sparkybg/UniSolder-5.2/BOM/UniSolder52C_front_BOM.xlsx

Designator | Quantity | Comment | Value | Description | Footprint | Package
C23, C47 | 2 | 220uf 10V | 220uf 10V | Tantalum SMD Capacitor | TANT D | D
C24, C25, C26, C27, C28, C29, C30, C31, C32, C33, C34, C35, C38, C39, C41, C42, C43, C44, C45, C46, C48, C49, C50, C51, C52, C53, C54, C58, C78 | 29 | 100n | 100n | Capacitor | 0603 capacitor | 0603
C36, C37, C40, C57, C79, C80, C81, C88 | 8 | 10u 16V | 10u 16V | Capacitor | 0805H Capacitor | 0805
C55, C56 | 2 | 15p | 15p | Capacitor | 0603 capacitor | 0603
C59, C60, C62, C65 | 4 | 10n 100V | 10n 100V | Capacitor | 0805H Capacitor | 0805
C61, C63, C64 | 3 | 1n | 1n | Capacitor | 0805 capacitor | 0805
C66 | 1 | 1n | 1n | Capacitor | 0805H Capacitor | 0805
D16, D20, D21, D23 | 4 | BAV199 |  | Low leakage double diode | SOT23 No Dot | SOT23
D18, D19 | 2 | MMBD1505A |  | Low leakage double diode | SOT23 No Dot | SOT23
ENCODER, OLED1, OLED2 | 3 | Header 5 |  | Header, 5-Pin | HDR1X5
J8 | 1 | CNTR |  | Header, 10-Pin | CABLE HEADER 2x5 2.54mm | 2x5x2.54
J9 | 1 | PWR |  | Header, 6-Pin | MOLEX 39-28-1063 6P
PD1 | 1 | Header 5 |  | Header, 5-Pin | HDR1X5 | 1x5x2.54
Q14, Q16, Q18, Q19, Q21, Q22 | 6 | IRLML6401 |  | HEXFET Power MOSFET | SOT23 No Dot | SOT23
R11, R12, R36, R40, R41, R45, R46, R58 | 8 | 3k | 3k | Resistor | 0805 Resistor | 0805
R23, R27, R28, R33, R44, R57 | 6 | 1.8k | 1.8k | Resistor | 0805 Resistor | 0805
R24, R34, R51, R60 | 4 | 1k 0.1% | 1k 0.1% | Resistor | 0805 Resistor | 0805
R25, R26 | 2 | 27 | 27 | Resistor | 0805 Resistor | 0805
R30, R35, R37, R42, R52, R54, R62, R65 | 8 | 1.5k 0.1% | 1.5k 0.1% | Resistor | 0805 Resistor | 0805
R31, R39 | 2 | 100 0.1% | 100 0.1% | Resistor | 0805 Resistor | 0805
R32 | 1 | 330 | 330 | Resistor | 0805 Resistor | 0805
R38, R48 | 2 | 47k 0.1% | 47k 0.1% | Resistor | 0805 Resistor | 0805
R43, R61, R64 | 3 | 15k | 15k | Resistor | 0805 Resistor | 0805
R47, R49, R50 | 3 | 27k 0.1% | 27k 0.1% | Resistor | 0805 Resistor | 0805
R53, R63 | 2 | 10k 0.1% | 10k 0.1% | Resistor | 0805 Resistor | 0805
R55, R56, R59 | 3 | 1.5k | 1.5k | Resistor | 0805 Resistor | 0805
R70 | 1 | 0 | 0 | Resistor | 0805 Resistor | 0805
Rc2 | 1 | 2k | 2k | Potentiometer | TRIMMER BOURNS 3314J | Bourns 3362
Rgnd1 | 1 | 10000k | 10000k | Resistor | 2512 RES-WIDE | 2512
S1, S2, S3 | 3 | SWITCH-TACTILE |  |  | SWITCH-TACTILE
SPK1 | 1 | PB1221P |  | Speaker 12mm | BUZZER 6.5R12 NO OVERLAY | SPK12x9x6.5
U4 | 1 | TC1047AVNBTR |  | Precision Temperature-to-Voltage Converter, 3-Pin SOT-23, Extended Temperature, Tape and Reel | SOT23 No Dot | SOT23
U5 | 1 | PIC32MX564F128H-I/PT |  | High Performance 80 MHz MIPS-Based 32-Bit Flash Microcontroller with USB and CAN, 128KB Program Memory, 64-pin TQFP, Industrial Temperature | TQFP64-50x1200x1200x120_N | TQFP64
U6 | 1 | REF3030 |  | 3.0V 0.2% 50ppm/C voltage reference | SOT23 No Dot | SOT23
U7 | 1 | ADuM3160 |  | USB Isolator | SOIC16W | SOIC16W
U8 | 1 | 24LC64-I/SN |  | 64Kbit, 400kHz, 2.5V, I2C Serial EEPROM, 8-Pin SOIC 150mil, Industrial Temperature | SOIC 8 | SOIC8
U10 | 1 | MCP4651-503E/ST |  | 8-Bit Dual I2C Digital POT with Volatile Memory, 14-pin TSSOP, Extended Temperature | TSSOP 14 | TSSOP14
U11 | 1 | MCP4716A0T-E/CH |  | 10-Bit Voltage Output Digital-to-Analog Converter with EEPROM and I2C Interface, 6-Pin SOT-23, Extended Temperature, Tape and Reel | SOT23-6 | SOT23-6
U12, U13 | 2 | MCP6V27-E/SN |  | 110 µA, High Precision Dual Op Amp, 8-Pin SOIC, Extended Temperature, 620 µA, 2 MHz Auto-Zeroed Dual Op Amp, 8-Pin SOIC, Extended Temperature | SOIC 8 NO DOT | SOIC8
U14 | 1 | LM4041CIM3-1.2 |  | Precision Micropower Shunt Voltage Reference, 3-pin SOT-23 | SOT23 No Dot | SOT23
U15 | 1 | MCP4561T-503E/MS |  | 8-Bit Single I2C Digital POT with Non-Volatile Memory, 8-pin MSOP, Extended Temperature, Tape and Reel | MSOP 8 DGK | MSOP8
U16 | 1 | ADG734 |  | AD 4 SPDT | TSSOP 20 | TSSOP20
U17 | 1 | MCP6V28-E/SN |  | 620 µA, 2 MHz Auto-Zeroed Op Amp with CS pin, 8-Pin SOIC, Extended Temperature | SOIC 8 NO DOT | SOIC8
U18 | 1 | MCP6V27-E/SN |  | 620 µA, 2 MHz Auto-Zeroed Dual Op Amp, 8-Pin SOIC, Extended Temperature | SOIC 8 | SOIC8
USB1 | 1 | USB 5 pin |  | Mini USB vertical connector | USB-B VERT MINI WURTH | MINIUSB-V
Y1 | 1 | 8Mhz | 8Mhz | Crystal Oscillator | HC49US | HC49US
ZD4 | 1 | 3V | 3V | Zener Diode | SOD123/miniMELF | SOD123
