sparkybg/UniSolder-5.2/BOM/UniSolder52C_full_BOM.xlsx

Designator | Quantity | Comment | Value | Description | Footprint | Package
C1, C3, C5, C7, C9, C10, C17, C18, C59, C60, C62, C65, C85, C86 | 14 | 10n 100V | 10n 100V | Capacitor | 0805H Capacitor | 0805
C2, C6, C12, C16, C20, C21, C67, C70, C73, C74, C77, C82, C87 | 13 | 100n 100V | 100n 100V | Capacitor, Capacitor (Semiconductor SIM Model) | 0805H Capacitor | 0805
C4 | 1 | 470uF 16V | 470uF 16V | Polarized Capacitor (Radial) | ELCAP 10x12.5 | TH10x12.5
C8, C11 | 2 | 220uF 50V | 220uF 50V | Polarized Capacitor (Radial) | ELCAP 10x12.5 | TH10x12.5
C13 | 1 | 22uF 50V | 22uF 50V | Polarized Capacitor (Radial) | ELCAP 5x11 RM2.0 | TH5x11
C14, C15, C19, C83 | 4 | 10u 25V | 10u 25V | Capacitor | 1206 Capacitor | 1206
C22 | 1 | 47uF 100V | 47uF 100V | Polarized Capacitor (Radial) | ELCAP 10x12.5 | TH10x12.5
C23, C47, C84 | 3 | 220uf 10V | 220uf 10V | Tantalum SMD Capacitor | TANT D | D
C24, C25, C26, C27, C28, C29, C30, C31, C32, C33, C34, C35, C38, C39, C41, C42, C43, C44, C45, C46, C48, C49, C50, C51, C52, C53, C54, C58, C78 | 29 | 100n | 100n | Capacitor | 0603 capacitor | 0603
C36, C37, C40, C57, C68, C69, C75, C79, C80, C81, C88 | 11 | 10u 16V | 10u 16V | Capacitor | 0805H Capacitor | 0805
C55, C56 | 2 | 15p | 15p | Capacitor | 0603 capacitor | 0603
C61, C63, C64 | 3 | 1n | 1n | Capacitor | 0805 capacitor | 0805
C66 | 1 | 1n | 1n | Capacitor | 0805H Capacitor | 0805
C71 | 1 | 10u 25V | 10u 25V | Capacitor | 1206H Capacitor | 0805
C76 | 1 | 100p | 100p | Capacitor | 0805 Capacitor | 0805
D1, D2, D3, D4 | 4 | FERD30H100SB-TR |  | FERD/Schottky Diode, FRTD/Schottky Diode | TO-252/D-PAK - diode | DO-201AD
D5, D8, D10, D14, D15 | 5 | BAT46WH |  | Schottky Rectifier | SOD123/miniMELF | SOD123
D6, D7, D12 | 3 | SS310A |  | Schottky Rectifier | DIODE SMA | SMA
D9, D11, D13 | 3 | 1N4007 |  | 1 Amp General Purpose Rectifier | DIODE SMA | SMA
D16, D20, D21, D23 | 4 | BAV199 |  | Low leakage double diode | SOT23 No Dot | SOT23
D18, D19 | 2 | MMBD1505A |  | Low leakage double diode | SOT23 No Dot | SOT23
D22 | 1 | SS34A |  | Schottky Rectifier | DIODE SMA | SMA
DISPLAY | 1 | UG-2864HSWEG01 |  | 0.96' 128x64 OLED Display | OLED 30X0.7
ENCODER, OLED1, OLED2 | 3 | Header 5 |  | Header, 5-Pin | HDR1X5
FUSE1 | 1 | F6.3A |  | LITTLEFUSE 0154 + HOLDER | 0154 Fuse+holder
J1 | 1 | 24VAC |  | Header, 2-Pin | MOLEX 39-28-1023 2P | 1x2x4.2
J2 | 1 | IRON |  | Header, 4-Pin | MOLEX 39-28-8040 4P | 2x2x4.2
J3, J9 | 2 | PWR |  | Header, 6-Pin | MOLEX 39-28-1063 6P
J4, J8 | 2 | CNTR |  | Header, 10-Pin | CABLE HEADER 2x5 2.54mm | 2x5x2.54
J5 | 1 | HOLDER |  | Header, 8-Pin | RJ11 VERT | RJ11V
J6 | 1 | SENSOR |  | Header, 3-Pin | CI31-3 | CI31-3
J7 | 1 | 24VDC |  | Header, 2-Pin | MOLEX 39-28-1023 2P | 1x2x4.2
L1 | 1 | 330uH | 330uH | Inductor | DRH125 Inductor | DRH125
L2, L4 | 2 | 330uH | 330uH | Inductor | DRH74 INDUCTOR | DRH74
L3 | 1 | 10uH | 10uH | Inductor | LPS4018 INDUCTOR | LPS4018
P1, P2 | 2 | Header 5 |  | Header, 5-Pin | Pin Header 2.54mm 1x5 | 1x5x2.54
PD1 | 1 | Header 5 |  | Header, 5-Pin | HDR1X5 | 1x5x2.54
Q1 | 1 | MJD122 |  | SOT223 NPN Silicon Planar Medium Power Darlington Transistor | SOT223+DPAK/TO252 | SOT89
Q2, Q8 | 2 | SUD50P08 |  | HEXFET Power MOSFET | TO-252/D-PAK | TO252
Q3, Q9 | 2 | MMBT5401 |  | PNP General-purpose Transistor | SOT23 No Dot | SOT23
Q4, Q5, Q12 | 3 | MMBT5551 |  | NPN General-purpose Transistor | SOT23 No Dot | SOT23
Q6, Q13 | 2 | BC847C |  | NPN General-purpose Transistor | SOT23 No Dot | SOT23
Q7 | 1 | BCX56-16 |  | NPN High-voltage Transistor | SOT89 | SOT89
Q10, Q11 | 2 | IPD053N08 |  | HEXFET N-Channel Power MOSFET | TO-252/D-PAK | TO252
Q14, Q16, Q18, Q19, Q21, Q22 | 6 | IRLML6401 |  | HEXFET Power MOSFET | SOT23 No Dot | SOT23
R1 | 1 | 10k | 10k | Resistor | 1206 Resistor | 1206
R2, R7, R15, R19, R21, R22 | 6 | 4.7k | 4.7k | Resistor | 0805 Resistor | 0805
R3 | 1 | 0 | 0 | Resistor | 0805 Resistor/Jumper | 0805
R4, R30, R35, R37, R42, R52, R54, R62, R65 | 9 | 1.5k 0.1% | 1.5k 0.1% | Resistor | 0805 Resistor | 0805
R5, R11, R12, R13, R16, R17, R36, R40, R41, R45, R46, R58, R68, R69 | 14 | 3k | 3k | Resistor | 0805 Resistor | 0805
R6, R9, R14 | 3 | 150 | 150 | Resistor | 0805 Resistor | 0805
R8, R18 | 2 | 30k | 30k | Resistor | 0805 Resistor | 0805
R10 | 1 | 10k | 10k | Resistor | 1206 Resistor | 0805
R20, R32 | 2 | 330 | 330 | Resistor | 0805 Resistor | 0805
R23, R27, R28, R33, R44, R57 | 6 | 1.8k | 1.8k | Resistor | 0805 Resistor | 0805
R24, R34, R51, R60 | 4 | 1k 0.1% | 1k 0.1% | Resistor | 0805 Resistor | 0805
R25, R26 | 2 | 27 | 27 | Resistor | 0805 Resistor | 0805
R31, R39 | 2 | 100 0.1% | 100 0.1% | Resistor | 0805 Resistor | 0805
R38, R48 | 2 | 47k 0.1% | 47k 0.1% | Resistor | 0805 Resistor | 0805
R43, R61, R64 | 3 | 15k | 15k | Resistor | 0805 Resistor | 0805
R47, R49, R50, R66 | 4 | 27k 0.1% | 27k 0.1% | Resistor | 0805 Resistor | 0805
R53, R63 | 2 | 10k 0.1% | 10k 0.1% | Resistor | 0805 Resistor | 0805
R55, R56, R59 | 3 | 1.5k | 1.5k | Resistor | 0805 Resistor | 0805
R67 | 1 | 820k | 820k | Resistor | 0805 Resistor | 0805
R70 | 1 | 0 | 0 | Resistor | 0805 Resistor | 0805
Rc2 | 1 | 2k | 2k | Potentiometer | TRIMMER BOURNS 3314J | Bourns 3362
Rgnd1 | 1 | 10000k | 10000k | Resistor | 2512 RES-WIDE | 2512
Rs1 | 1 | 0.003 | 0.003 | 4lead shunt resistor | RES VISHAY WSL3637 | WSL3637
S1, S2, S3 | 3 | SWITCH-TACTILE |  |  | SWITCH-TACTILE
SPK1 | 1 | PB1221P |  | Speaker 12mm | BUZZER 6.5R12 NO OVERLAY | SPK12x9x6.5
TVS1 | 1 | 60V |  | Tranzorb | DIODE SMC | DO-201AD
U1 | 1 | LM2675M-3.3 |  | SIMPLE SWITCHER® Power Converter High Efficiency 1A Step-Down Voltage Regulator, 8-pin Narrow SOIC | SOIC 8 | SOIC8
U2 | 1 | TC4428ACOA |  | 1.5A Dual High-Speed Power MOSFET Driver, Complementary, Commercial Temperature | SOIC 8 NO DOT | SOIC8
U3 | 1 | SN74HC02D |  | Quadruple 2-Input Positive-NOR Gate | SOIC 14 | SOIC14
U4 | 1 | TC1047AVNBTR |  | Precision Temperature-to-Voltage Converter, 3-Pin SOT-23, Extended Temperature, Tape and Reel | SOT23 No Dot | SOT23
U5 | 1 | PIC32MX564F128H-I/PT |  | High Performance 80 MHz MIPS-Based 32-Bit Flash Microcontroller with USB and CAN, 128KB Program Memory, 64-pin TQFP, Industrial Temperature | TQFP64-50x1200x1200x120_N | TQFP64
U6 | 1 | REF3030 |  | 3.0V 0.2% 50ppm/C voltage reference | SOT23 No Dot | SOT23
U7 | 1 | ADuM3160 |  | USB Isolator | SOIC16W | SOIC16W
U8 | 1 | 24LC64-I/SN |  | 64Kbit, 400kHz, 2.5V, I2C Serial EEPROM, 8-Pin SOIC 150mil, Industrial Temperature | SOIC 8 | SOIC8
U10 | 1 | MCP4651-503E/ST |  | 8-Bit Dual I2C Digital POT with Volatile Memory, 14-pin TSSOP, Extended Temperature | TSSOP 14 | TSSOP14
U11 | 1 | MCP4716A0T-E/CH |  | 10-Bit Voltage Output Digital-to-Analog Converter with EEPROM and I2C Interface, 6-Pin SOT-23, Extended Temperature, Tape and Reel | SOT23-6 | SOT23-6
U12, U13 | 2 | MCP6V27-E/SN |  | 110 µA, High Precision Dual Op Amp, 8-Pin SOIC, Extended Temperature, 620 µA, 2 MHz Auto-Zeroed Dual Op Amp, 8-Pin SOIC, Extended Temperature | SOIC 8 NO DOT | SOIC8
U14 | 1 | LM4041CIM3-1.2 |  | Precision Micropower Shunt Voltage Reference, 3-pin SOT-23 | SOT23 No Dot | SOT23
U15 | 1 | MCP4561T-503E/MS |  | 8-Bit Single I2C Digital POT with Non-Volatile Memory, 8-pin MSOP, Extended Temperature, Tape and Reel | MSOP 8 DGK | MSOP8
U16 | 1 | ADG734 |  | AD 4 SPDT | TSSOP 20 | TSSOP20
U17 | 1 | MCP6V28-E/SN |  | 620 µA, 2 MHz Auto-Zeroed Op Amp with CS pin, 8-Pin SOIC, Extended Temperature | SOIC 8 NO DOT | SOIC8
U18 | 1 | MCP6V27-E/SN |  | 620 µA, 2 MHz Auto-Zeroed Dual Op Amp, 8-Pin SOIC, Extended Temperature | SOIC 8 | SOIC8
U19 | 1 | FAN5331 |  | LED boost driver | SOT23-6 | SOT23-5
USB1 | 1 | USB 5 pin |  | Mini USB vertical connector | USB-B VERT MINI WURTH | MINIUSB-V
Y1 | 1 | 8Mhz | 8Mhz | Crystal Oscillator | HC49US | HC49US
ZD1, ZD2, ZD4 | 3 | 3V | 3V | Zener Diode | SOD123/miniMELF | SOD123
ZD3 | 1 | 36V | 36V | Zener Diode | DIODE SMB | SOD123
ZD5, ZD6, ZD7 | 3 | 15V | 15V | Zener Diode | SOD123/miniMELF | SOD123
