sparkybg/UniSolder-5.2/BOM/UniSolder52C_back_OLED_BOM.xlsx

Designator | Quantity | Comment | Value | Description | Footprint | Package
C1, C3, C5, C7, C9, C10, C17, C18, C85, C86 | 10 | 10n 100V | 10n 100V | Capacitor | 0805H Capacitor | 0805
C2, C6, C12, C16, C20, C21, C87 | 7 | 100n 100V | 100n 100V | Capacitor | 0805H Capacitor | 0805
C4 | 1 | 470uF 16V | 470uF 16V | Polarized Capacitor (Radial) | ELCAP 10x12.5 | TH10x12.5
C8, C11 | 2 | 220uF 50V | 220uF 50V | Polarized Capacitor (Radial) | ELCAP 10x12.5 | TH10x12.5
C13 | 1 | 22uF 50V | 22uF 50V | Polarized Capacitor (Radial) | ELCAP 5x11 RM2.0 | TH5x11
C14, C15, C19, C83 | 4 | 10u 25V | 10u 25V | Capacitor | 1206 Capacitor | 1206
C22 | 1 | 47uF 100V | 47uF 100V | Polarized Capacitor (Radial) | ELCAP 10x12.5 | TH10x12.5
C67, C70, C73, C74, C77 | 5 | 100n 100V |  | Capacitor (Semiconductor SIM Model), Capacitor | 0805H Capacitor
C68, C69, C75 | 3 | 10u 16V |  | Capacitor | 0805H Capacitor
C71 | 1 | 10u 25V |  | Capacitor | 1206H Capacitor
C76 | 1 | 100p |  | Capacitor | 0805 Capacitor
C82 | 1 | 100n | 100n | Capacitor | 0805H Capacitor | 0805
C84 | 1 | 220uf 10V | 220uf 10V | Tantalum SMD Capacitor | TANT D | D
D1, D2, D3, D4 | 4 | FERD30H100SB-TR |  | FERD/Schottky Diode, FRTD/Schottky Diode | TO-252/D-PAK - diode | DO-201AD
D5, D8, D10, D14, D15 | 5 | BAT46WH |  | Schottky Rectifier | SOD123/miniMELF | SOD123
D6, D7, D12 | 3 | SS310A |  | Schottky Rectifier | DIODE SMA | SMA
D9, D11, D13 | 3 | 1N4007 |  | 1 Amp General Purpose Rectifier | DIODE SMA | SMA
D22 | 1 | SS34A |  | Schottky Rectifier | DIODE SMA
DISPLAY1 | 1 | UG-2864HSWEG01 |  | 0.96' 128x64 OLED Display | OLED 30X0.7
FUSE1 | 1 | F6.3A |  | LITTLEFUSE 0154 + HOLDER | 0154 Fuse+holder
J1 | 1 | 24VAC |  | Header, 2-Pin | MOLEX 39-28-1023 2P | 1x2x4.2
J2 | 1 | IRON |  | Header, 4-Pin | MOLEX 39-28-8040 4P | 2x2x4.2
J3 | 1 | PWR |  | Header, 6-Pin | MOLEX 39-28-1063 6P
J4 | 1 | CNTR |  | Header, 10-Pin | CABLE HEADER 2x5 2.54mm | 2x5x2.54
J5 | 1 | HOLDER |  | Header, 8-Pin | RJ11 VERT | RJ11V
J6 | 1 | SENSOR |  | Header, 3-Pin | CI31-3 | CI31-3
J7 | 1 | 24VDC |  | Header, 2-Pin | MOLEX 39-28-1023 2P | 1x2x4.2
L1 | 1 | 330uH | 330uH | Inductor | DRH125 Inductor | DRH125
L2, L4 | 2 | 330uH | 330uH | Inductor | DRH74 INDUCTOR | DRH74
L3 | 1 | 10uH |  | Inductor | LPS4018 INDUCTOR
P1, P2 | 2 | Header 5 |  | Header, 5-Pin | PIN HEADER 2.54MM 1X5
Q1 | 1 | MJD122 |  | SOT223 NPN Silicon Planar Medium Power Darlington Transistor | SOT223+DPAK/TO252 | SOT89
Q2, Q8 | 2 | SUD50P08 |  | HEXFET Power MOSFET | TO-252/D-PAK | TO252
Q3, Q9 | 2 | MMBT5401 |  | PNP General-purpose Transistor | SOT23 No Dot | SOT23
Q4, Q5, Q12 | 3 | MMBT5551 |  | NPN General-purpose Transistor | SOT23 No Dot | SOT23
Q6, Q13 | 2 | BC847C |  | NPN General-purpose Transistor | SOT23 No Dot | SOT23
Q7 | 1 | BCX56-16 |  | NPN High-voltage Transistor | SOT89 | SOT89
Q10, Q11 | 2 | IPD053N08 |  | HEXFET N-Channel Power MOSFET | TO-252/D-PAK | TO252
R1 | 1 | 10K | 10k | Resistor | 1206 Resistor | 1206
R2, R7, R15, R19, R21, R22 | 6 | 4.7K | 4.7k | Resistor | 0805 Resistor | 0805
R3 | 1 | 0 | 0 | Resistor | 0805 Resistor/Jumper | 0805
R4 | 1 | 1.5k 0.1% | 1.5k 0.1% | Resistor | 0805 Resistor | 0805
R5, R13, R16, R17 | 4 | 3k | 3k | Resistor | 0805 Resistor | 0805
R6, R9, R14 | 3 | 150 | 150 | Resistor | 0805 Resistor | 0805
R8, R18 | 2 | 30k | 30k | Resistor | 0805 Resistor | 0805
R10 | 1 | 10k | 10k | Resistor | 1206 Resistor | 0805
R20 | 1 | 330 | 330 | Resistor | 0805 Resistor | 0805
R66 | 1 | 27k 0.1% |  | Resistor | 0805 Resistor
R67 | 1 | 820k |  | Resistor | 0805 Resistor
R68, R69 | 2 | 3k |  | Resistor | 0805 Resistor
Rs1 | 1 | 0.003 | 0.003 | 4lead shunt resistor | RES VISHAY WSL3637 | WSL3637
TVS1 | 1 | 60V |  | Tranzorb | DIODE SMC | DO-201AD
U1 | 1 | LM2675M-3.3 |  | SIMPLE SWITCHER® Power Converter High Efficiency 1A Step-Down Voltage Regulator, 8-pin Narrow SOIC | SOIC 8 | SOIC8
U2 | 1 | TC4428ACOA |  | 1.5A Dual High-Speed Power MOSFET Driver, Complementary, Commercial Temperature | SOIC 8 NO DOT | SOIC8
U3 | 1 | SN74HC02D |  | Quadruple 2-Input Positive-NOR Gate | SOIC 14 | SOIC14
U19 | 1 | FAN5331 |  | LED boost driver | SOT23-6
ZD1, ZD2 | 2 | 3V | 3V | Zener Diode | SOD123/miniMELF | SOD123
ZD3 | 1 | 36V | 36V | Zener Diode | DIODE SMB | SOD123
ZD5, ZD6, ZD7 | 3 | 15V | 15V | Zener Diode | SOD123/miniMELF | SOD123
