sparkybg/UniSolder-5.2/BOM/UniSolder52C_back_BOM.xlsx

Designator | Quantity | Comment | Package | Description | Footprint
C1, C3, C5, C7, C9, C10, C17, C18, C85, C86 | 10 | 10n 100V | 0805 | Capacitor | 0805H Capacitor
C2, C6, C12, C16, C20, C21, C82, C87 | 8 | 100n 100V | 0805 | Capacitor | 0805H Capacitor
R2, R7, R15, R19, R21, R22 | 6 | 4.7k | 0805 | Resistor | 0805 Resistor
D5, D8, D10, D14, D15 | 5 | BAT46WH | SOD123 | Schottky Rectifier | SOD123/miniMELF
C14, C15, C19, C83 | 4 | 10u 25V | 1206 | Capacitor | 1206 Capacitor
D1, D2, D3, D4 | 4 | FERD30H100SB-TR | DO-201AD | FERD/Schottky Diode, FRTD/Schottky Diode | TO-252/D-PAK - diode
R5, R13, R16, R17 | 4 | 3k | 0805 | Resistor | 0805 Resistor
D6, D7, D12 | 3 | SS310A | SMA | Schottky Rectifier | DIODE SMA
D9, D11, D13 | 3 | 1N4007 | SMA | 1 Amp General Purpose Rectifier | DIODE SMA
Q4, Q5, Q12 | 3 | MMBT5551 | SOT23 | NPN General-purpose Transistor | SOT23 No Dot
R6, R9, R14 | 3 | 150 | 0805 | Resistor | 0805 Resistor
ZD5, ZD6, ZD7 | 3 | 15V | SOD123 | Zener Diode | SOD123/miniMELF
C8, C11 | 2 | 220uF 50V | TH10x12.5 | Polarized Capacitor (Radial) | ELCAP 10x12.5
L2, L4 | 2 | 330uH | DRH74 | Inductor | DRH74 INDUCTOR
Q2, Q8 | 2 | SUD50P08 | TO252 | HEXFET Power MOSFET | TO-252/D-PAK
Q3, Q9 | 2 | MMBT5401 | SOT23 | PNP General-purpose Transistor | SOT23 No Dot
Q6, Q13 | 2 | BC847C | SOT23 | NPN General-purpose Transistor | SOT23 No Dot
Q10, Q11 | 2 | IPD053N08 | TO252 | HEXFET N-Channel Power MOSFET | TO-252/D-PAK
R1, R10 | 2 | 10k | 1206, 0805 | Resistor | 1206 Resistor
R8, R18 | 2 | 30k | 0805 | Resistor | 0805 Resistor
ZD1, ZD2 | 2 | 3V | SOD123 | Zener Diode | SOD123/miniMELF
C4 | 1 | 470uF 16V | TH10x12.5 | Polarized Capacitor (Radial) | ELCAP 10x12.5
C13 | 1 | 22uF 50V | TH5x11 | Polarized Capacitor (Radial) | ELCAP 5x11 RM2.0
C22 | 1 | 47uF 100V | TH10x12.5 | Polarized Capacitor (Radial) | ELCAP 10x12.5
C84 | 1 | 220uf 10V | D | Tantalum SMD Capacitor | TANT D
FUSE1 | 1 | F6.3A |  | LITTLEFUSE 0154 + HOLDER | 0154 Fuse+holder
J1 | 1 | 24VAC | 1x2x4.2 | Header, 2-Pin | MOLEX 39-28-1023 2P
J2 | 1 | IRON | 2x2x4.2 | Header, 4-Pin | MOLEX 39-28-8040 4P
J3 | 1 | PWR |  | Header, 6-Pin | MOLEX 39-28-1063 6P
J4 | 1 | CNTR | 2x5x2.54 | Header, 10-Pin | CABLE HEADER 2x5 2.54mm
J5 | 1 | HOLDER | RJ11V | Header, 8-Pin | RJ11 VERT
J6 | 1 | SENSOR | CI31-3 | Header, 3-Pin | CI31-3
J7 | 1 | 24VDC | 1x2x4.2 | Header, 2-Pin | MOLEX 39-28-1023 2P
L1 | 1 | 330uH | DRH125 | Inductor | DRH125 Inductor
Q1 | 1 | MJD122 | SOT89 | SOT223 NPN Silicon Planar Medium Power Darlington Transistor | SOT223+DPAK/TO252
Q7 | 1 | BCX56-16 | SOT89 | NPN High-voltage Transistor | SOT89
R3 | 1 | 0 | 0805 | Resistor | 0805 Resistor/Jumper
R4 | 1 | 1.5k 0.1% | 0805 | Resistor | 0805 Resistor
R20 | 1 | 330 | 0805 | Resistor | 0805 Resistor
Rs1 | 1 | 0.003 | WSL3637 | 4lead shunt resistor | RES VISHAY WSL3637
TVS1 | 1 | 60V | DO-201AD | Tranzorb | DIODE SMC
U1 | 1 | LM2675M-3.3 | SOIC8 | SIMPLE SWITCHER® Power Converter High Efficiency 1A Step-Down Voltage Regulator, 8-pin Narrow SOIC | SOIC 8
U2 | 1 | TC4428ACOA | SOIC8 | 1.5A Dual High-Speed Power MOSFET Driver, Complementary, Commercial Temperature | SOIC 8 NO DOT
U3 | 1 | SN74HC02D | SOIC14 | Quadruple 2-Input Positive-NOR Gate | SOIC 14
ZD3 | 1 | 36V | SOD123 | Zener Diode | DIODE SMB
