sparkybg/UniSolder-5.2/BOM/UniSolder52C_OLED_BOM.xlsx

Designator | Quantity | Comment | Description | Package | Value
DISPLAY | 1 | UG-2864HSWEG01 | 0.96' 128x64 OLED Display
C68, C69, C75 | 3 | 10u 16V | Capacitor | 0805 | 10u 16V
C71 | 1 | 10u 25V | Capacitor | 0805 | 10u 25V
C76 | 1 | 100p | Capacitor | 0805 | 100p
C67, C70, C73, C74, C77 | 5 | 100n 100V | Capacitor (Semiconductor SIM Model), Capacitor | 0805 | 100n 100V
P1, P2 | 2 | Header 5 | Header, 5-Pin | 1x5x2.54
L3 | 1 | 10uH | Inductor | LPS4018 | 10uH
U19 | 1 | FAN5331 | LED boost driver | SOT23-5
R66 | 1 | 27k 0.1% | Resistor | 0805 | 27k 0.1%
R67 | 1 | 820k | Resistor | 0805 | 820k
R68, R69 | 2 | 3k | Resistor | 0805 | 3k
D22 | 1 | SS34A | Schottky Rectifier | SMA
