sparkybg/UniSolder-5.2/(list of files, cad)

Other CAD files:
software/sensor/US_sensor.X/dist/default/production/US_sensor.X.production.obj
software/sensor/US_sensor.X/l.obj
