sparkybg/UniSolder-5.2/img/UniSolder52_back.jpg

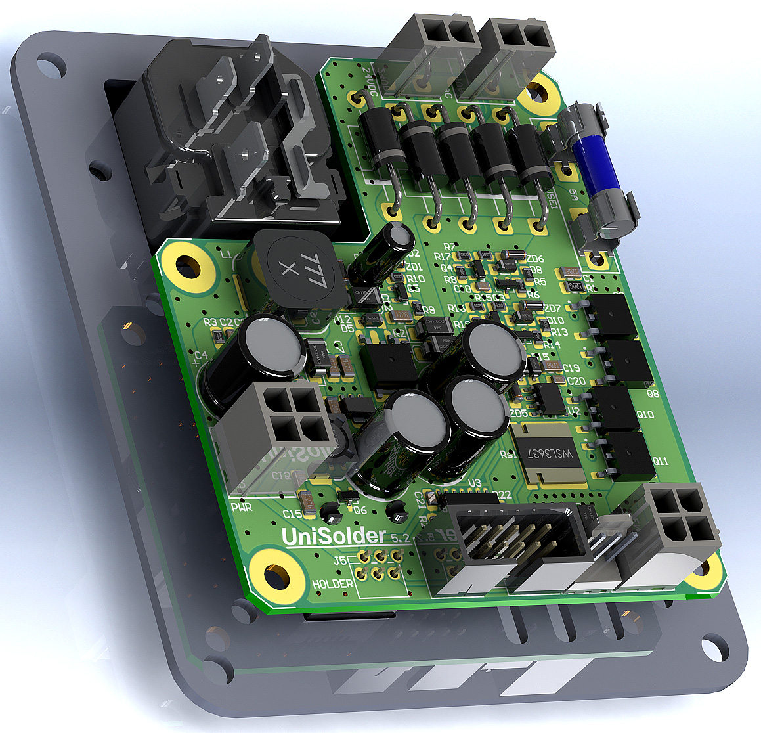
img/UniSolder52_back.jpg
