sparkybg/UniSolder-5.2/img/UniSolder52_front_OLED.jpg

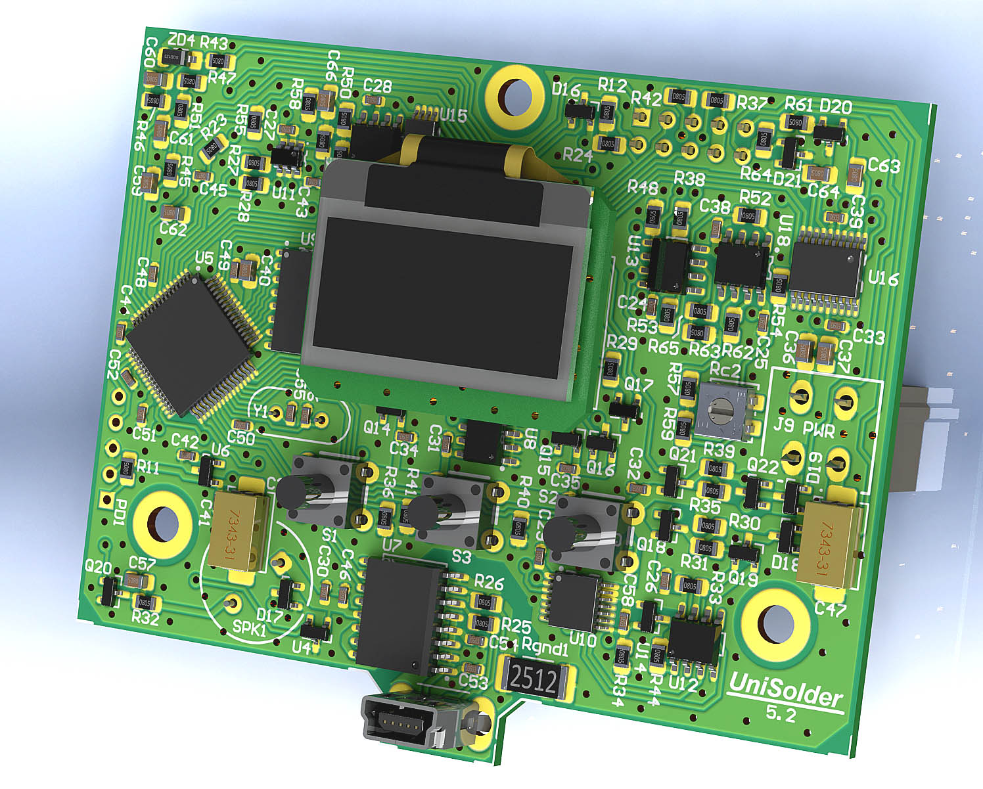
img/UniSolder52_front_OLED.jpg
