sparkybg/UniSolder-5.2/(threads)

Thread 5 (2021-02-01):

OLED Internal charge pump setup swaped for SSH1106 and SSD1306

Janesak1977, 2021-02-01:
**This is actual  code**
if(DisplaySetup.SH1106){
        PreUpdateBuff.PreRowUpdate.ColLow = 2; //SSH1106 is 131x64 - shift right by 2
        mcuSPISendByte(0x8D); //charge pump control
        mcuSPISendByte(DisplaySetup.InternalChargePump ? 0x14 : 0x10);
    }
    else{
        PreUpdateBuff.PreRowUpdate.ColLow = 0; //SSD1306 is 128x64 - no need to shift
        mcuSPISendByte(0xAD); //charge pump control
        mcuSPISendByte(DisplaySetup.InternalChargePump ? 0x8B : 0x8A);
    }

**Correct is**
if(DisplaySetup.SH1106){
        PreUpdateBuff.PreRowUpdate.ColLow = 2; //SSH1106 is 131x64 - shift right by 2
        mcuSPISendByte(0xAD); //charge pump control
        mcuSPISendByte(DisplaySetup.InternalChargePump ? 0x8B : 0x8A);
    }
    else{
        PreUpdateBuff.PreRowUpdate.ColLow = 0; //SSD1306 is 128x64 - no need to shift
        mcuSPISendByte(0x8D); //charge pump control
        mcuSPISendByte(DisplaySetup.InternalChargePump ? 0x14 : 0x10);
    }

sparkybg, 2021-02-01:
Yes, it seems so. Correct it then, and open a pull request. It must be the same in the bootloader also. I won't have the time soon.

Closed 2021-02-02.

Thread 7 (2021-02-03):

Feature request: show firmware version

Vogs27, 2021-02-03:
Can be useful show the loaded firmware version somewhere, maybe in the calibration or in the info menu. In this way not only it's easy to know which firmware is currently running, but also aknowledge a correct firmware update.

Closed 2021-02-03.

Thread 8 (2021-04-21):

After I burn the firmware, the screen shows 45

ws786873, 2021-04-21:
Is this a fault code? Do you have the corresponding documents?

robpneu, 2021-04-21:
Error 45 is the I2C communication not working, usually with the EEPROM chip (U8). It is likely dead. [Forum posts with the same issue](http://dangerousprototypes.com/forum/index.php?topic=7218.msg72881#msg72881) and [confirmation that it was the resolution](http://dangerousprototypes.com/forum/index.php?topic=7218.msg72898#msg72898)

ws786873, 2021-04-21:
thank you~

------------------&nbsp;原始邮件&nbsp;------------------
发件人: "Rob ***@***.***&gt;;
发送时间: 2021年4月22日(星期四) 凌晨0:05
收件人: ***@***.***&gt;;
抄送: ***@***.***&gt;; ***@***.***&gt;;
主题: Re: [sparkybg/UniSolder-5.2] After I burn the firmware, the screen shows 45 (#8)

Error 45 is the I2C communication not working, usually with the EEPROM chip (U8). It is likely dead. Forum posts with the same issue and confirmation that it was the resolution

—
You are receiving this because you authored the thread.
Reply to this email directly, view it on GitHub, or unsubscribe.

ws786873, 2021-04-22:
Today, after I confirmed that there is no problem with the connector I made, it should be the problem with the U8. Then I found that 21 would be displayed before 45. What's the problem？

sparkybg, 2021-04-22:
45 is right before it tries to read the parameters from EEPROM. So, it is most likely that your EEPROM chip is malfunctioning.

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

ws786873, 2021-04-25:
Hi~i replace the U8,but display 21 then 45

sparkybg, 2021-04-25:
Then something else on the I2C line is malfunctioning.

Check if the pull-up resistors are located correctly.

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

ws786873, 2021-04-26:
your meaning is R27 and R28?,They are ok.

Closed 2021-05-01.

Thread 9 (2021-04-30):

Toroidal vs Meanwell

cammas, 2021-04-30:
Dear Unisolderers, can you please explain to me what makes a Meanwell [RPS-120-24](https://www.meanwell.com/webapp/product/search.aspx?prod=RPS-120) a worse power supply than a toroidal transformer? Thanks you!

robpneu, 2021-04-30:
Below is sparkybg’s explanation ([source](https://dangerousprototypes.com/forum/index.php?topic=7218.msg61341#msg61341)); please note that “SMPS” means “Switching Mode Power Supply”, which is what most DC brick power supplies are (like those for laptops), and it looks like the supply you linked.

"In short using SMPS, you've got several times higher probabilities of something going wrong with the earth. Moreover, since JBC tips have a connection in them between the outer shell (which must be grounded) and one of the terminals, you should not ground the SMPS, but the tip itself. But most of the SMPS I've used, have a capacitor between one of the output terminals and ground/enclosure, so it needs a little thinking/experimentation where exactly to put the grounding and how to connect the wires between the power supply and controller, in order to avoid ground loops and some other things."

So if grounding is important to you (and for a bench iron, it probably should be), a toroidal transformer connected to AC mains and EARTH is recommended. To minimize clicking sounds, an epoxy impregnated transformer is best. To drive all of the possible handles, the ideal is a 24V, 6A transformer, which is 144 VA. 160VA is the most common power rating that I've seen that meets this criteria.

cammas, 2021-04-30:
Ok so If I understand correctly a toroidal transformer is better than a crappy SMSPS? Can you a high quality SMPS? I need a power dense power supply that runs on 110 and 220VAC.

robpneu, 2021-04-30:
From what I've seen on the forum, the only recommendation is don't do it. I don't think "high quality" makes a difference here.

cammas, 2021-04-30:
Every few months with couple days notice. [relevant thread](https://www.eevblog.com/forum/projects/diy-jbc-nano/25/)

robpneu, 2021-04-30:
I would suggest getting a 110/220 to 12/24 toroidal transformer, like [this one](https://octopart.com/vpt24-6670-triad+magnetics-10567051), and add a 110/220 switch on the back, like [this one](https://www.amazon.com/outstanding-Voltage-Selector-Terminals-Switches/dp/B07TWWBSBB).

You'd wire it so the output is always in series (giving you 24V), but the input would be switched between series (for 230 VAC) and parallel (for 115 VAC) using the switch above.

labjr61, 2021-04-30:
I plan to build this project and I want the most reliable power supply. Nothing is more simple than a traditional transformer. If I wanted compact and lightweight for portability I would buy a Pinecil or TS100 iron.

BTW, this surplus house has a suitable transformer which was made in Canada by ILP which was a division of Plitron. So good quality. I have a couple of them already.  https://www.surplussales.com//item/_tp/t-2404a.html

robpneu, 2021-04-30:
> I plan to build this project and I want the most reliable power supply. Nothing is more simple than a traditional transformer. If I wanted compact and lightweight for portability I would buy a Pinecil or TS100 iron.

Agreed. I really like my Pinecil; highly recommended for the portability!

> BTW, this surplus house has a suitable transformer which was made in Canada by ILP which was a division of Plitron. So good quality. I have a couple of them already. https://www.surplussales.com//item/_tp/t-2404a.html
That transformer looks good, though I don't think it would meet @cammas's voltage input needs since it looks like it only has a single input

labjr61, 2021-04-30:
> That transformer looks good, though I don't think it would meet @cammas's voltage input needs since it looks like it only has a single input (at 120 V)

Oh I didn't see that single primary. I'd never have a transformer made with a single primary. I service electronic music equipment and Japanese companies like Roland and Yamaha always used single voltage transformers. That drives me crazy since they could've easily made it universal. I guess they did it for marketing reasons.

sparkybg, 2021-05-01:
Just to mention - in the past, the firmware and hardware had some issues when working with low quality transofrers, but this was a long time ago. This is the reason of at least 2 of the older (pre 5.2) hardware revisions. From 5.2 on and with the later firmware, it can work with REALLY nasti transformers without any issues other than some clicking noise from the thansformer.

I recommend a high quality toridal, exactly because it is more compact, weights less, makes less audible noises, and has HUGELY less leakage inductance, which means HUGELY less inductive peaks and  HUGELY lower instability issues when 1/2. 1/4 and 1/8 power is used.

I don't know for original JBC controller with SMPS in it, and there's a reason for it - phisical connection between the outer shell of the tips and the heater, whish, as I mentioned, means that you must keep your entire SMPS not grounded and isolated from everything (including the case), and connect the earth ONLY to the tip's outer shell, which sometimes is hard to do.

Another thing to mention is that with SMPS you will have to get and overpowered unit or unit current limiter (not protection, but limiter). Some (maybe most) of them are reacting pretty fast on overcurrent, shutting the unit down. And some of the tips (C210 for еxample) have such low resistance that their peak current is much higher than averane current, which may trigger the SMPS protection.

So think a little more when deciding what power supply to choose - for reliable work you may end up with SMPS that is both larger and heavier than a simple 120-150VA toroidal, that handles peak currents of at least 3 times their rating without any problems.

cammas, 2021-05-22:
To clarify, I wasn't asking if it's possible or not to use DC. Alot of people are buying and building theses kits, I was just wondering if power supplies could be referenced since they are required. Just like @labjr61 listed [toroidal](https://www.surplussales.com//item/_tp/t-2404a.html) If it was possible to list other power supplies people can buy to finish their unisolders. I hope my request is resonable for us to work on

Closed 2021-12-20.

Thread 10 (2021-06-09):

Measured tip temperature stays at ~26C despite full power blown in the heater

m-kozlowski, 2021-06-09:
Problem appeared in 2020.06 release, but I'm observing it in current master as well.
The tip quickly goes red, but the controller still thinks it's at room temperature.
It works correctly after reverting back to previous release.
Using C210, MX564F128H.

m-kozlowski, 2021-06-09:
narrowed it down to commit 3fd78cdac4acf813e8b50ac502d377aff723f95a

sparkybg, 2021-12-20:
It now works. Tested!

Closed 2021-12-20.

Thread 12 (2022-08-08):

5.2C Schematics show 100nF power decoupling cap outputs ganged together

rokkoyama, 2022-08-08:
5.2C front schematic shows 100nF power decoupling cap ganged together downstream, across all of the uC inputs.

PCB shows caps dedicated to each of the pins 10, 19, 26, 38, 57 as would be expected.

Please confirm the schem should be corrected.

sparkybg, 2022-08-08:
Schematic is correct. There is no need for capacitors to be dedicated on schematic also. They are between Vdd and Gnd and this is corretcly shown on chematics.

Closed 2022-08-08.

Thread 13 (2022-12-07):

C245 Thermocouple calibration (not an issue, the forum doesn't work)

alpemwarrior, 2022-12-07:
Hi there, I'm working on a controller of my own (nothing wrong with unisolder, just too complex for me :) ) and wanted to find what exact thermocouple type is on the C245 series cartridges by JBC. I've done quite a bit of research I finally think it's a so-called type M thermocouple (Ni/Mo - Ni/Co), because at the temperature these cartridges were calibrated at (I understand that would be 183ºC for 63/37 solder) this type of thermocouple has the exact same EMF output as unisolder would expect (using 43,5uV/ºC). It would also fit all the descriptions of the materials I've been able to find. Attached is a graph I made for reference.

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

**What I wanted to ask**, seeing that you worked with both pure lead and 63/37, is whether the TC output was observed to be strictly linear or if when calibrated at 183 °C the station displayed a temperature higher than real at 327,5 °C (melting lead).

I'm happy to close this issue if deemed inappropriate, thanks in advance.

labjr61, 2022-12-07:
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

Interesting. Let us know if you start a new thread elsewhere.

alpemwarrior, 2022-12-07:
Dear lord am I dumb. Thanks a lot for the answer.

Closed 2022-12-07.

Thread 14 (2023-11-19):

Open Source PCB to revive the project

GreekGeorge, 2023-11-19:
A lot of components have gone up in price and/or are no longer available. Currently it is almost impossible to make a unisolder.
By open sourcing the PCBs, updates to the BOMs and footprints would bring the project back, as well as add new features (rotary encoder, larger displays, tip grounding with a GPIO instead of an IR system).

sparkybg, 2023-11-29:
Which components? There was shortages, but now, as far as I can see, everything is again available from Farnell for example.

Most of the parts with shortage in the past were closely related with firmware (amp input switch, digital pots, DACs), so it is not that easy to replace them.

For tip grounding (I assume you are talking for "iron-in-stand" detector) - it is, in fact GPIO. You can do the same with a simple switch or any other solution that can act as switch, whic is exactly what IR detector dows. There is also a touch sensing solution in the thread at dangerousprototypes.

PCBs are made with a closed source, paid software. I opensourced everything I could.

JBlocklove, 2024-08-30:
Looks like you've made the schematic and, I assume, PCB layout in Altium Designer. There's absolutely no reason that using Altium would mean you can't open source those files, Altium themselves even specifically highlight open source projects which were made using their software: https://resources.altium.com/p/open-source-hardware-projects-in-altium-designer.

People who want to mess with this might also have access to Altium or want to port the project to something more open-source friendly like KiCAD, so having those files in the repo would be invaluable for people to be able to make updates and changes. Just because there are challenges involved with the routing and such doesn't mean that no one else could figure it out.

If you don't want to share the source that's fine, it's your project, but the fact that it's made using a closed source software shouldn't be the reason.

maciejopalinski, 2024-12-26:
I am refining the project and redesigning it in KiCad using components that are as universal as possible. In my opinion, the current design is overly complex and not cost-efficient.

sparkybg, 2024-12-26:
> I am refining the project and redesigning it in KiCad using components that are as universal as possible. In my opinion, the current design is overly complex and not cost-efficient.

Keep in mind that MANY parts are critical, and the most critical thing is the PCB power and ground routing. Many people tried many part substitutions and PCB redesign, and the final result was not good.

Most important - you have analog groud for current sources, analog ground for amplifiers and digital ground for the digital part. You have seperate power for analog sircuits and digiral part. This is IMPORTANT! We are dealing with microvolts and amps, and we are dealing with gain of 750. Also, 0.1% resistors are important too.

A current flow in wrong place creates offsets. These offsets create offsets in current sources, then these offsets iin current sources create voltage offsets that are amplified 750 times! The analog part must be VERY carefully routed, respecting the above facts. ot it WONT work as expected!

On my boards, there are no offsets, there are no different temperatures on different channels, there are no problems with calibration. Several other people had these problems.

I can help you with specific question in the design process, if you still want to do it.

Thread 15 (2023-11-29):

Compilation failed

SUzhouTaoTao, 2023-11-29:
I used mplab-v6.1.5 xc32-v4.35(free)  and the compilation failed. What version do you use?

sparkybg, 2023-11-29:
You need legacy peripheral libraries in order to compile it. It is distributed separately. It can be downloaded from microchip's web site.

sparkybg, 2023-11-29:
And, there is a compiled HEX files in the project folders. You may use them instead.

SUzhouTaoTao, 2023-11-29:
> 而且，项目文件夹中有一个编译的 HEX 文件。您可以改用它们。

This gives me some direction. Thanks for answering the question

SUzhouTaoTao, 2023-11-29:
> You need the Legacy Peripheral Libraries in order to compile it. It is distributed separately. It can be downloaded from microchip's web site.

I got it done, thanks

Closed 2023-11-29.

Thread 16 (2024-02-01):

Restricting automatic tip detection

PBrunot, 2024-02-01:
We have an elusive problem on our FabLab with Unisolder where the wrong tip is detected, and this resulted in a burned tip. Troubleshooting has not been successfull. We would like to implement a software workaround, and I open this issue for advice.

I was thinking to add a parameter to disable the auto-detection in IronIdentify() function, with a logic as follows:

1) if a new tip is detected, different from the last model saved in EEPROM
2) check if the auto-detect parameter is enabled, if YES -> keep the existing logic
3) if NO, set a global variable to flash on the screen the "auto-detect disabled" message and keep old tip ID

Other changes required:
- Edit pars / eprom accordingly
- Add saving in EPROM at poweroff of the last valid tip

Potential design issue:
- Behaviour in case of this sequence : old tip -> 0x1919 -> new tip . Should we keep the old tip ? Allow autodetect if tip has been disconnected? Maybe we will have spurious changes anyways.

Alternative design:
- add a parameter to allow setup a fixed IronID and bypass detection ?

Thanks for your feedback about the kind of solution to this problem would you be open to merge as pull request.

PBrunot, 2024-02-26:
It is simpler to implement the change in hardware by putting the resistors in the inside of the unisolder.
