sparkybg/UniSolder-5.2/schematics/sensor.pdf

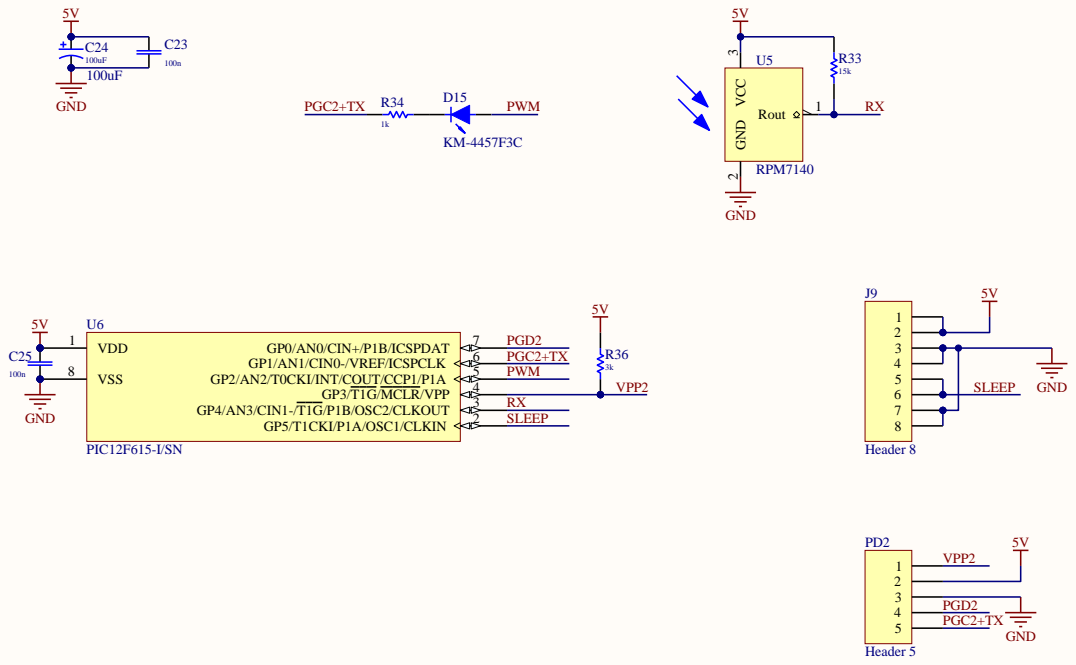
[picture p5: page 1]

Size A4 | Number | Revision

Date: 12.04.2020 | Sheet of
File: C:\Users\..\UniSolder_sensor.SchDoc | Drawn By:
