sparkybg/UniSolder-5.2/schematics/5.2C/UniSolder5.2C_front.pdf

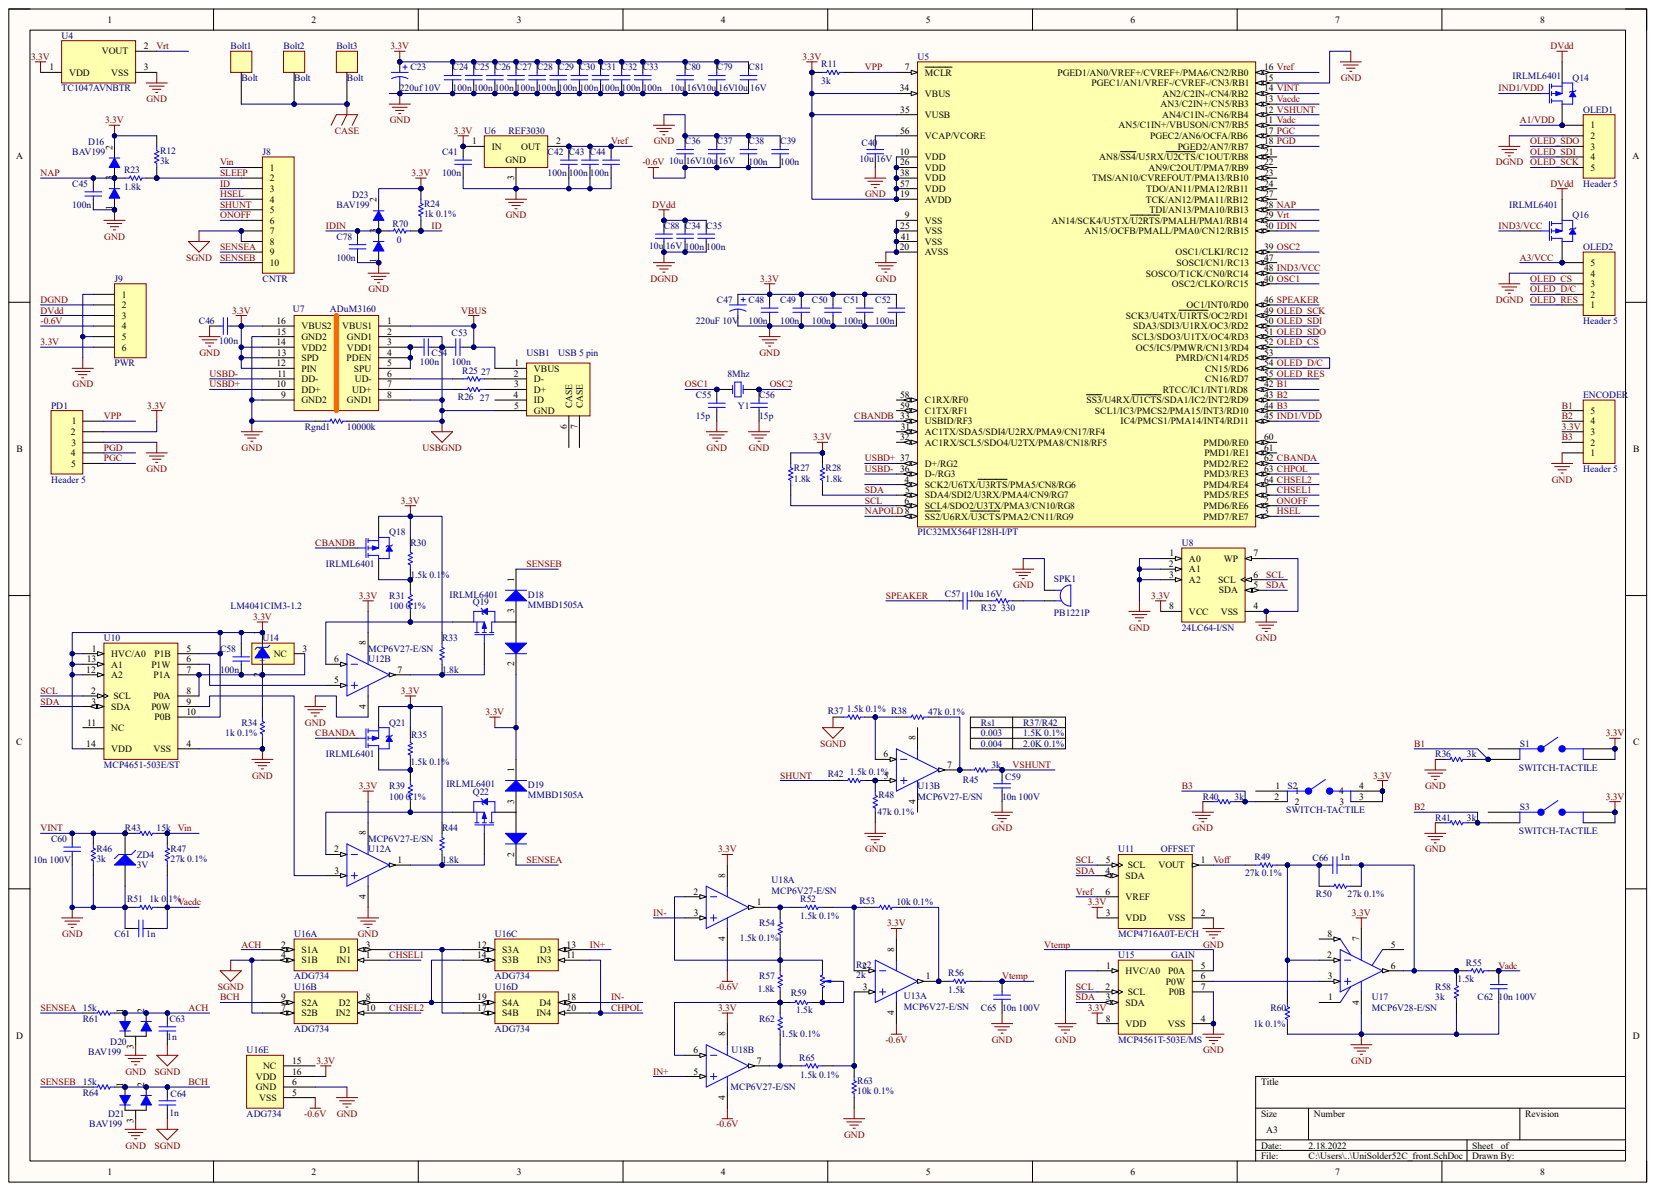
[picture p6: page 1]

0.003 1.5K 0.1%
0.004 2.0K 0.1%
