sparkybg/UniSolder-5.2/schematics/5.2C/UniSolder5.2C_OLED.pdf

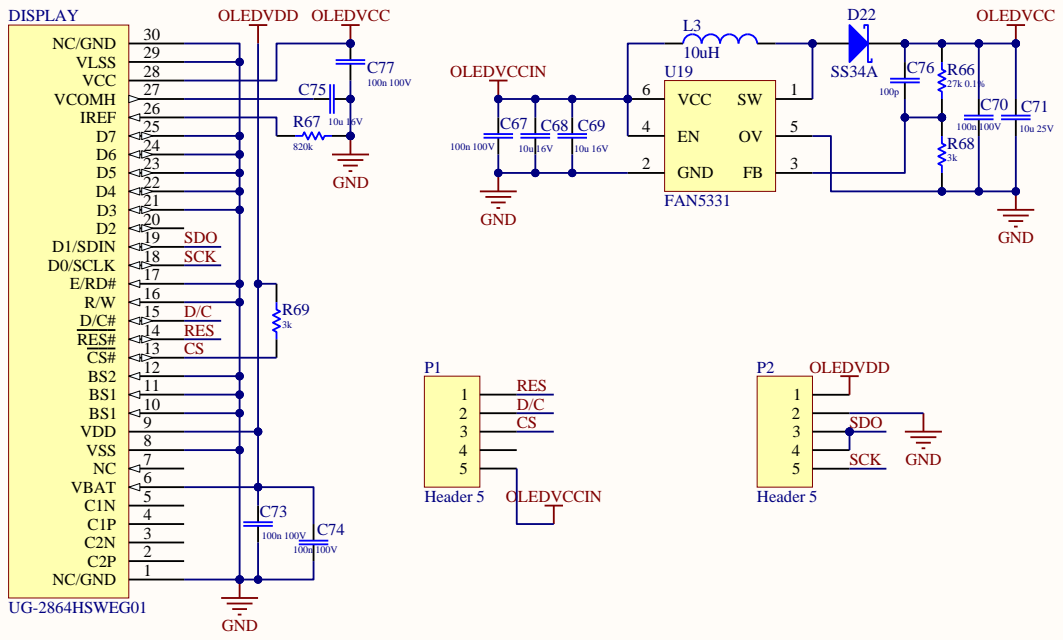
[picture p8: page 1]

Size A4 | Number | Revision

Date: 12.05.2020 | Sheet of
File: C:\Users\..\UniSolder52C_OLED.SchDoc Drawn By:
