sparkybg/UniSolder-5.2/schematics/5.2/UniSolder52_back.pdf

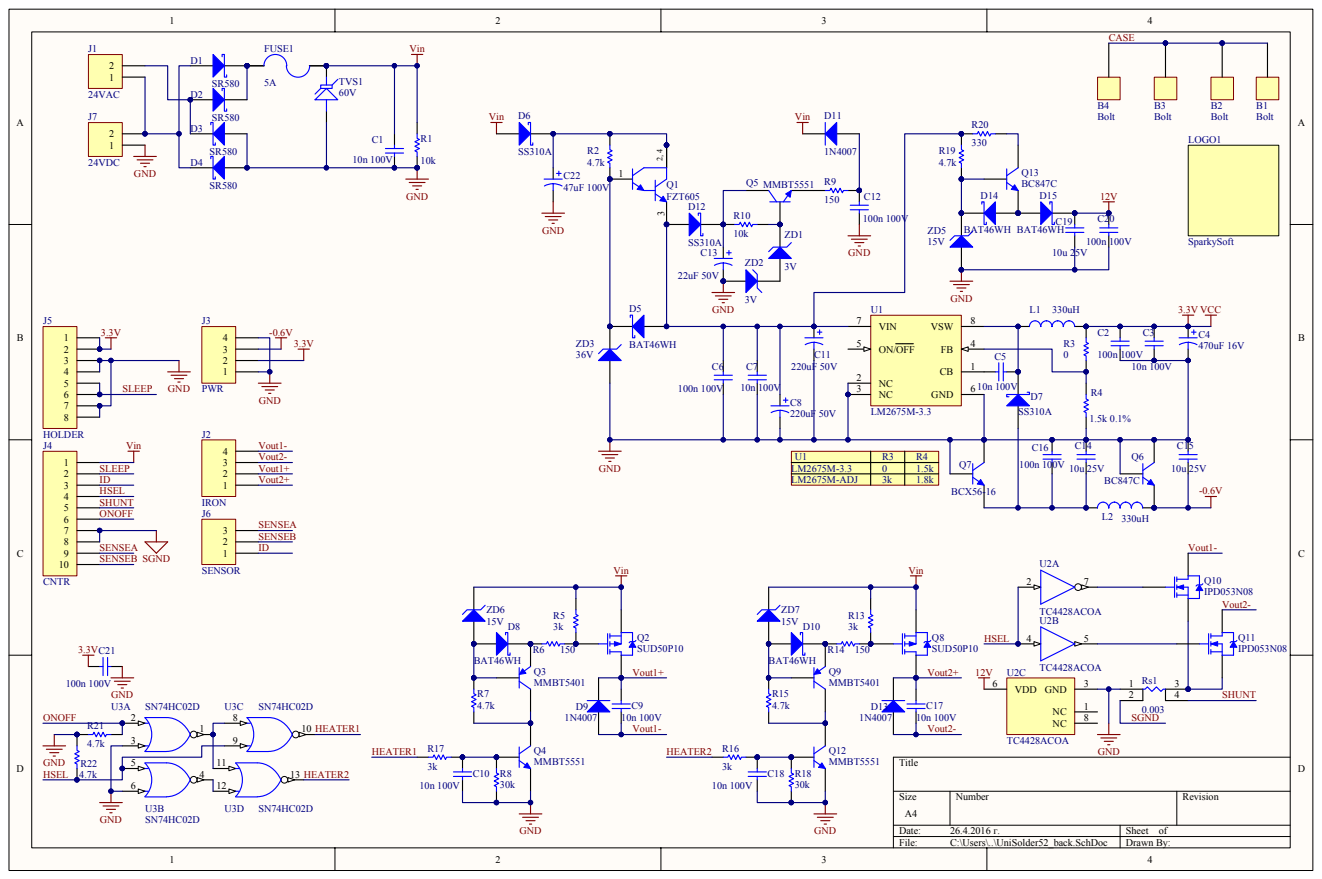
[picture p9: page 1]

Size A4 | Number | Revision

Date: 26.4.2016 г. | Sheet of
File: C:\Users\..\UniSolder52_back.SchDoc | Drawn By:
