sparkybg/UniSolder-5.2/schematics/5.2/UniSolder52_front.pdf

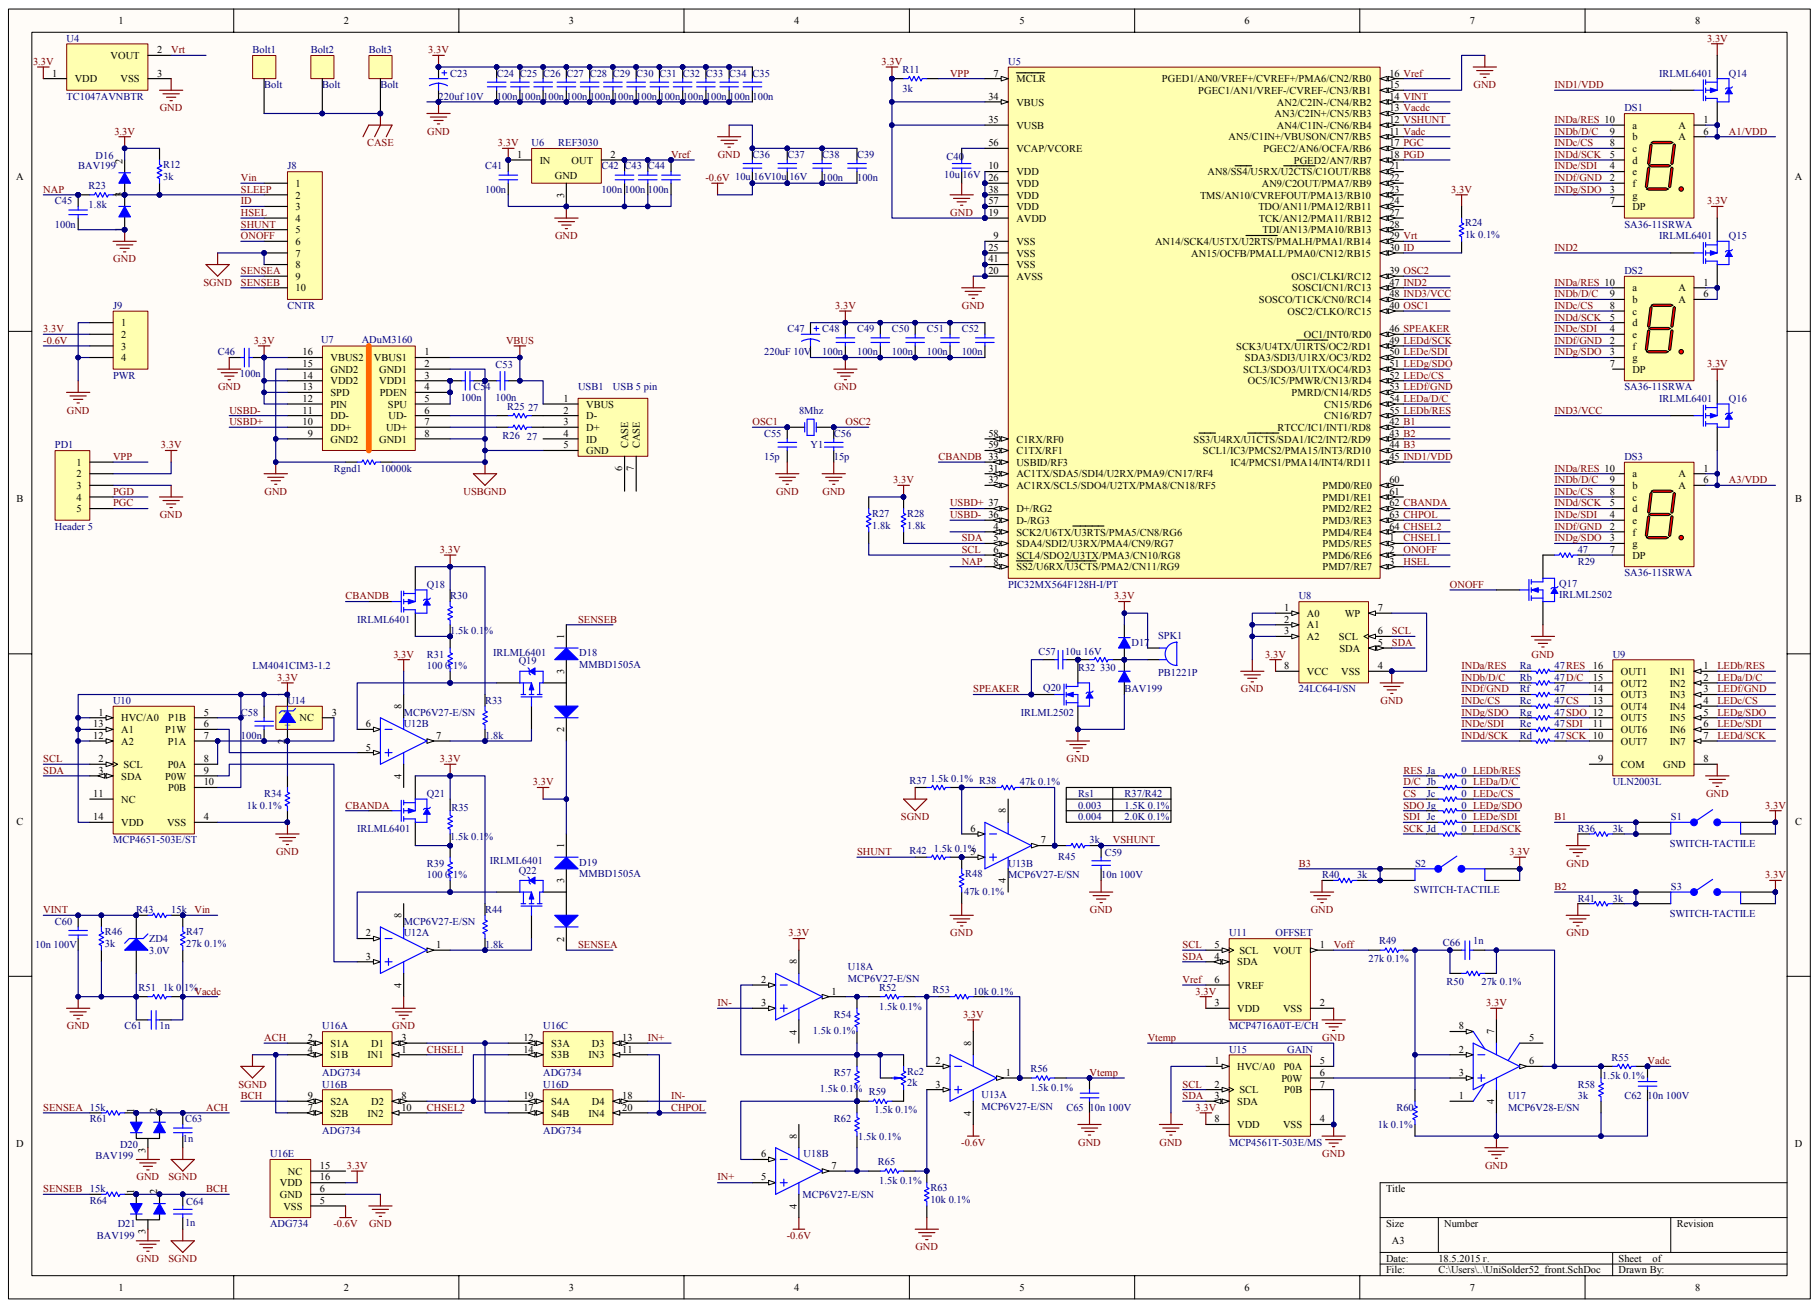
[picture p10: page 1]

Size A3 | Number | Revision

Date: 18.5.2015 г. | Sheet of
File: C:\Users\..\UniSolder52_front.SchDoc | Drawn By:
