sparkybg/UniSolder-5.2/schematics/5.2/UniSolder52_OLED.pdf

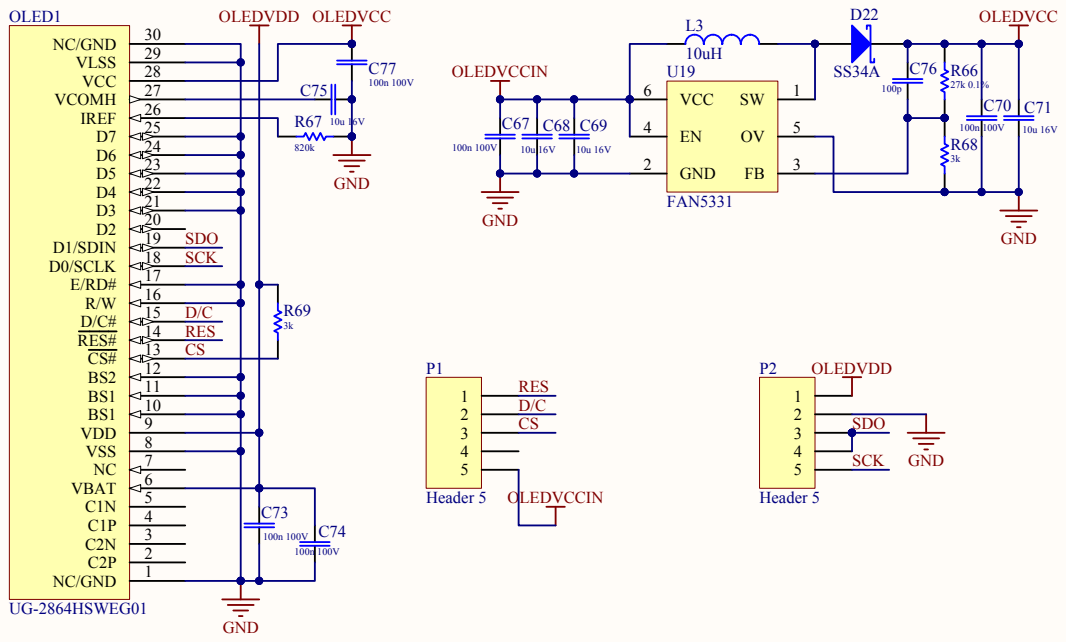
[picture p11: page 1]

Size A4 | Number | Revision

Date: 14.1.2015 г. | Sheet of
File: C:\Users\..\UniSolder52_OLED.SchDoc | Drawn By:
