sparkybg/UniSolder-5.2/software/front/US_Firmware.X/logo.h

/* 
 * File:   font6x8.h
 * Author: Sparky
 *
 * Created on ??????, 2015, ????? 11, 19:42
 */

#ifndef LOGO_H
#define	LOGO_H

#ifdef	__cplusplus
extern "C" {
#endif

const UINT8 logo[1024] = {
  0xff, 0xff, 0xff, 0xff, 0xff, 0xff, 0xff, 0xff, 
  0xff, 0xff, 0xff, 0xff, 0xff, 0xff, 0xff, 0xff, 
  0xff, 0xff, 0xff, 0xff, 0xff, 0xff, 0xff, 0xff, 
  0xff, 0xff, 0xff, 0xff, 0xff, 0xff, 0xff, 0xff, 
  0xff, 0xff, 0xff, 0xff, 0xff, 0xff, 0xff, 0xff, 
  0xff, 0xff, 0xff, 0xff, 0xff, 0xff, 0xff, 0xff, 
  0xff, 0xff, 0xff, 0xff, 0xff, 0xff, 0xdf, 0xff, 
  0xff, 0xff, 0xff, 0xff, 0xff, 0xff, 0xff, 0xf8, 
  0xff, 0xff, 0xff, 0xff, 0xff, 0xff, 0xef, 0xff, 
  0xff, 0xff, 0xff, 0xfe, 0x3f, 0xff, 0xff, 0xff, 
  0xff, 0xff, 0xff, 0xfe, 0x3f, 0xff, 0xff, 0xff, 
  0xff, 0xff, 0xff, 0xfe, 0x3f, 0xff, 0xff, 0xff, 
  0xff, 0xff, 0xff, 0xf8, 0x7f, 0xff, 0xff, 0xef, 
  0xff, 0xff, 0xfc, 0x00, 0x3f, 0xf7, 0xff, 0xbf, 
  0xff, 0xff, 0xfc, 0x00, 0x3f, 0xff, 0xff, 0x7f, 
  0xff, 0xff, 0xfc, 0x00, 0x3f, 0xff, 0xfe, 0xff, 
  0xff, 0xff, 0xff, 0xff, 0xff, 0xbf, 0xfd, 0xff, 
  0xff, 0xff, 0xff, 0xff, 0xff, 0xff, 0xfb, 0xfe, 
  0xff, 0xff, 0xff, 0xe3, 0xfe, 0xff, 0xf7, 0xfd, 
  0xff, 0xff, 0xfe, 0x60, 0xfd, 0xff, 0xef, 0xfb, 
  0xff, 0xff, 0xfc, 0x60, 0x7b, 0xff, 0xdf, 0xf7, 
  0xff, 0xff, 0xfc, 0x60, 0x3f, 0xff, 0x3f, 0xef, 
  0xff, 0xff, 0xfc, 0x66, 0x3f, 0xfe, 0xbf, 0xdf, 
  0xff, 0xff, 0xfc, 0x67, 0x3f, 0xff, 0x7f, 0xbf, 
  0xff, 0xff, 0xfc, 0x67, 0x3f, 0xff, 0xff, 0x7f, 
  0xff, 0xff, 0xfc, 0x26, 0x3f, 0xff, 0xfe, 0xff, 
  0xff, 0xfe, 0xfe, 0x00, 0x3f, 0xff, 0xfd, 0xff, 
  0xff, 0xfe, 0x7e, 0x00, 0x7f, 0xff, 0xfb, 0xff, 
  0xff, 0xff, 0xff, 0x00, 0xff, 0xff, 0xf7, 0xff, 
  0xff, 0xfb, 0xff, 0xc3, 0xff, 0xff, 0xef, 0xfd, 
  0xff, 0xf7, 0xff, 0xff, 0xff, 0xff, 0xdf, 0xfa, 
  0xff, 0xff, 0xff, 0xff, 0xff, 0xe0, 0x3f, 0xf9, 
  0xff, 0xdf, 0xfc, 0x00, 0x00, 0xff, 0xff, 0xf7, 
  0xff, 0xbf, 0xfc, 0x00, 0x00, 0xff, 0xff, 0xef, 
  0xff, 0xff, 0xfc, 0x00, 0x00, 0xff, 0xff, 0xdf, 
  0xfe, 0xff, 0xfc, 0x00, 0x01, 0xff, 0xff, 0xbf, 
  0xfd, 0xff, 0xfe, 0x3e, 0x3f, 0xff, 0xfe, 0x7f, 
  0xff, 0xff, 0xfc, 0x7e, 0x3f, 0xfd, 0xfd, 0x7f, 
  0xff, 0xff, 0xfc, 0x7e, 0x3f, 0xfa, 0xfe, 0xff, 
  0xff, 0xff, 0xfc, 0x3e, 0x3f, 0xf9, 0xff, 0xff, 
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
};


#ifdef	__cplusplus
}
#endif

#endif	/* LOGO_H */
