sparkybg/UniSolder-5.2/software/front/US_Firmware.X/mcu.h

/* 
 * File:   mcu.h
 * Author: Sparky
 *
 * Created on ?????, 2013, ??? 31, 0:00
 */

#ifndef MCU_H
#define	MCU_H

#ifdef	__cplusplus
extern "C" {
#endif
    
#include <xc.h>
#include "PIC32MX564F128H.h"

#ifdef	__cplusplus
}
#endif

#endif	/* MCU_H */
