sparkybg/UniSolder-5.2/(commit log)

2020-11-03 New Features, new iron
    - Added PACE TD200 Blue
    - Menu rotates.
    - Menu options rotates.
    - Display toration (0, 180deg)
    - Wake from standby (OFF, Key, Holder, Both)
    - Button swap options (+/-, -/+)
    - Display brighness option now works
    [OLED.c, PID.c, iron.c, menu.c, pars.c, pars.h]
2020-11-03 Added holder sensor filtering
2020-11-03 DMA SPI, 5Mhz, display address init
2020-11-04 New features, new iron, bugfixes
    New:
    - JBC Nanotweezers
    - Option for menu scroll UP/DOWN
    - Option for display start column
    - Menu scrolls forever freely
    Bugfixes:
    - Corrected JBC C105 profile
    - Corrected PACE TD200 Blue profile
    [OLED.c, iron.c, main.c, main.h, menu.c, pars.c, pars.h]
2020-11-07 Revised iron profiles, display detection
    - Detection of SSD1306/SH1106
    - Revised all JBC, all PACE, and HAKKO T15 profiles due to malfunction in my controller's current sources.
    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
    [OLED.c, OLED.h, PIC32MX534F064H.c, iron.c, isr.c, main.c, main.h, menu.c]
2020-11-08 SH1106 offset too high
    [OLED.c]
2020-11-09 Bug fixes. New features
    - Bouncing stand-by text.
    - Displays "HOT" when in stand-by and iron temperature is > 60 C
    - Instruments starts at 1/4 power and ramp up when needed
    - Revised power selection algorhytm
    - Added "Instrumrnd information" option in the menu
    - Instrument ID now displayed in HEX
    - One more digid for resistance in Calibration screen
    - When in calibration, controller does not seqrch for instrument, and now the SENSEA and SENSEB currents are constant and can be measured with miltimeter.
    - Stand-by screen now displays normal
    - No overshoot on JBC C210 and considerably reduced on JBC Microtweezers
    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
    [OLED.c, OLED.h, PIC32MX564F128H.h, PID.c, PID.h, iron.c, isr.c, main.c]
2020-11-13 Display detection, Iron CJ sensor reading
2020-11-16 Cold temperature bug, PIC32MX564F128H
    - The MCU supported now is PIC32MX564F128H (was PIC32MX534F064H)
    - Temperature goes to 511C and controller refuses to heat up when tip is cold.
    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
    [PIC32MX564F128H.c, PIC32MX564F128H.h, PID.c, isr.c, mcu.h, sensorMath.c, sensorMath.h]
2020-11-19 New features.
    - Added support for rotary encoder
    - Added temperature step option
    - Rearranged menu option locations
    - Revisited ISR timing around zero cross
    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
2020-12-02 Board version detection
2020-12-03 Revision 5.2C 4-layer boards
    [unisolder52_back.gbl, unisolder52_back.gbo, unisolder52_back.gbs, unisolder52_back.gko, unisolder52_back.gtl, unisolder52_back.gto, unisolder52_back.gts, unisolder52_front.gbl]
2020-12-03 Correction on gerber file names
2020-12-04 1/8 power, Tip-change
    - Support for 1/8 power
    - Support for Tip-Change function
    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
2020-12-05 Some errors on PCB component names
    - front R68 -> R88 (was also R68_1 on front in full PCB gerbers, now is R88)
    - back L3 -> L4 (was also L3_1 on OLED in full PCB gerbers, now is L3)
    - OLED1_1 on front in full gerbers -> OLED1
    - OLED1 on OLED in full gerbers -> DISPLAY
    [UniSolder52C.xlsx]
2020-12-06 Calibration menu shows holder status
2020-12-08 BOM and PP
    [UniSolder52C.xlsx, UniSolder52C_OLED_BOM.xlsx, UniSolder52C_OLED_PP.xlsx, UniSolder52C_back_BOM.xlsx, UniSolder52C_back_PP.xlsx, UniSolder52C_front_BOM.xlsx, UniSolder52C_front_PP.xlsx, UniSolder52C_full_BOM.xlsx]
2020-12-10 Back+OLED combined board
    Added Back+OLED combined board, BOM and pick-and-place
    [UniSolder52C_back_OLED_BOM.xlsx, UniSolder52C_back_OLED_PP.xlsx]
2021-01-04 BigFix: Button inputs were configured as outputs
2021-01-05 Cleanup activity step1
    First step enable all compiler warnings.
    Remove some of the warnings.
    Replaced some magic numbers with defines.
    Add version in the menu.
    [OLED.c, OLED.h, PIC32MX564F128H.c, PIC32MX564F128H.h, PID.c, PID.h, io.c, io.h]
2021-01-05 Include current directory
    In order to avoid giving relative path to include files
2021-01-10 Firmware version info
    Add firmare version as static define MAJOR and MINOR
    Create enum for menu mode
    Create enum for board hw version
2021-01-10 Remove unused files
    [l.obj]
2021-01-15 cleanup, print issue corrected
    [OLED.c, menu.c]
2021-01-17 Fix the bootloader
    Unfortunately the bootloader was broken after warnings
    removal patch.
    Also took the opportunity to remove the unused files.
    [l.obj]
2021-02-02 Update OLED.c
    Fixed OLED Internal charge pump setup for SSH1106 and SSD1306
    [OLED.c]
2021-12-20 DC Power Detect
    It now detects DC power loss correctly.
    [OLED.c, PIC32MX564F128H.c, isr.c, main.c, menu.c, menu.h]
2022-02-18 R70 must be 0ohm, profiles corrected
    [UniSolder52C_front_BOM.xlsx, UniSolder52C_front_PP.xlsx, UniSolder52C_full_BOM.xlsx, UniSolder52C_full_PP.xlsx]
2022-02-18 Added option for AB-1PDD encoder
2022-02-19 Logo added. C245 profile corrected
    [OLED.h, PIC32MX564F128H.c, iron.c, logo.h, main.c]
