sparkybg/UniSolder-5.2/(notices)

Notices in the files:
README.md:
License CC-BY-4.0
